solv-stoy-teknikk/optical-workbench/hardware/Optical Stage & Fittings/mini-optical-alignment-mechanism-workbench-model_files/1049401-mini-optical-alignment-mechanism-workbench-0076dabe-c984-4b47-a395-e0c5865c34db.pdf

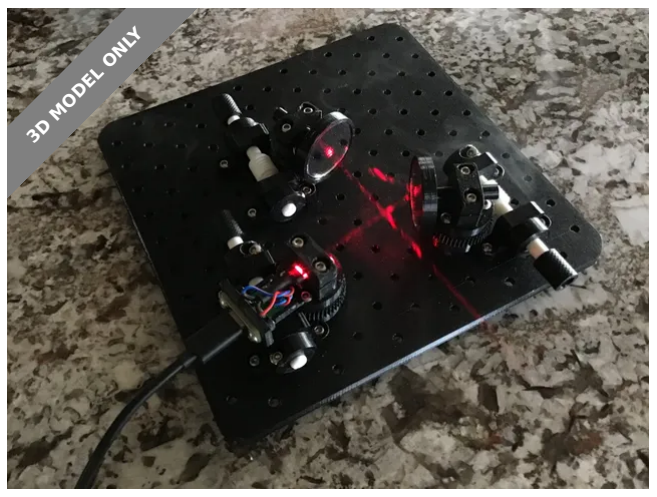
[picture p1: figure]
3D MODEL ONLY

## Summary

This is a handy Mini Optical Alignment Mechanism for 360° adjustments in the X-Y direction and a ± 10° tilt in the Z.

Learning (https://printables.com/model?categoryId=90) > Other 3D Objects for Learning (https://printables.com/model?categoryId=96)

Tags: | engineering | laser | classroom | scienceproject
scienceeducation | wormgear | teachingtool | optical
physicsproject | physicsexperiment | mathematicaldesgin
physicsdemonstration | educationalproject | positioner
educationaltools | lightshow | physicslab | classroomtools
physicsdemo | physicsclass | opticalworkbench | laserart

This MiniOptical Alignment Mechanism is a practical adjustment instrument designed to enable the precise positioning of lasers & optical components in all three dimensional spaces; i.e. X, Y, and Z. It includes a generic mounting platform for compatibility with a wide range of optical devices (with the use of an appropriate adapter); a dedicated mount for a 6mm dia. laser diode and a 25mm dia. mirror mount. The worm gear mechanism allows for smooth and accurate adjustments, ensuring optimal yba2cuo3 (https://printables.com/@yba2cuo3_12119)

## Mini Optical Alignment Mechanism & Workbench

VIEW IN BROWSER (https://printables.com/model/1049401-mini-optical-alignment-mechanism-workbench)

updated 2. 11. 2024 | published 2. 11. 2024

alignment in any test scenario. The design makes it an essential tool for any project requiring reliable positioning of optical components, from scientific or classroom experiments, to hobbyist projects, it delivers a cost-effective solution in a compact easy-to-use system.

STAY TUNED FOR UPCOMING PROJECTS INVOLVING THIS OPTICAL ALGINMENT MECHANISM!

Project Challenge #1: Lissajous Figure Laser Light-Show Pattern
Generator & Projector by yba2cuo3 | Download free STL model |
Printables.com (https://www.printables.com/model/1043751-lissajous-figure-laser-light-show-pattern-generato)

Features

Adaptable Mini-Optical Workbench for Demonstration & Experimentation;
360° Fine-Tunable Alignment Mechanism in the X-Y direction using Worm Gears;
± 10° Z-Tilt Adjustment using 3-sided pivot springs & screws; 6mm dia. Laser Diode Mount;
25mm dia. Mirror Mount;
Generic Component Mount to fit other optical components with custom adapters.
Dimensions: 165x165x40mm

It is designed to be used with this mini-optical workbench: Mini Optical
Workbench by yba2cuo3 | Download free STL model | Printables.com (https://www.printables.com/model/1049366-mini-optical-workbench)

Print Settings

Printer brand: Prusa
Model: i3 MK2S
Supports: Yes
Resolution: 0.15mm OPTIMAL Infill: 20%
Brim: Yes - 10 to 20mm
Filament brand: Doesn't matter Filament material: PLA
Filament color: Doesn't matter

Construction

The construction is relatively simple, making use of M3 hardware. A list of assembly material is provided below, along with where it's used. Also check the description associated with each file for more assembly details.

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
Assembly Tips:

Don't forget to insert the small printed sleeve inside the worm gear shaft hole to prevent wobbling;
There are 3 elongated mounting holes in the Mini Optical Workbench. This is where the worm gear screw/shaft goes. The slot allows for the adjustment of the worm gear distance to the worm with the ability to achieve a smooth & consistent rotation between both parts. When tightening the shaft nut, make sure that it is tight enough to prevent lateral or up & down movement of the gear, but not too tight which would prevent the free rotation of the gear;
The worm contact location on the worm gear can also be adjusted slightly; i.e. either ahead or behind the gear, by moving the position of the collars on the worm shaft;
Make sure that there is minimum play between the collars & pillow blocks but not too tight also to allow the free rotation of the worm. If everything is properly adjusted, the worm & gear should turn freely without any skipping of teeth or seizing.

List of Required Assembly Hardware

All HW is Stainless Steel Button Head Hex Socket Head Cap Screws and Nuts, unless specified otherwise.

•

•

•

•

•

Common (per Worm Gear Assembly)
Qty Description | Where Used
2 | M3 washer | Worm gear shaft washer - under screw head & nut
1 | M3 Nyloc nut | Worm gear shaft nut - install under workbench
4 | M3x8 screw | Pillow blocks
2 | M3x8 screw | Collars used on worm to restrict travel
1 | M3x8 screw | Knob at end of worm
1 | M3x16 screw | Worm gear shaft
3 | M3x16 screw | For Z-adjust. Secures worm gear to laser, mirror or generic mounts.
3 | 4mm Spring | Ball point pen Compression Spring for Z-adjust. Wire Diameter 0.4mm x Outer Diameter 4mm x Length 15mm. Note: You can cut your ball point spring to the appropriate length. Check: Amazon- spring (https://www.amazon.ca/gp/product/B08FMJN2P9/ref=ppx_yo_dt_b_search_asin_title?ie=UTF8&psc=1)

Laser Mount
Qty Description | Where Used
2 | M3x8 screw | For Laser mount (top)
1 | 6mm, 5mW Laser Diode | For Alignment of optical components. The wire leads will need to be soldered to the USB-c PCB; i.e. red wire to Vcc (or V marking on PCB) & blue (or black) to GND (or G). Check: Amazon-Laser (https://www.amazon.ca/gp/product/B07FM6FDFM/ref=ppx_yo_dt_b_search_asin_title?ie=UTF8&psc=1)
2 | M3x8 screw | For installing the USB-c PCB on the Laser Bottom Mount
1 | USB-c PCB | Female Socket for powering the +5VDC Laser. Use a standard +5VDC USB AC adapter. Check: Amazon-USBc (https://www.amazon.ca/gp/product/B0D5B96FBR/ref=ppx_yo_dt_b_search_asin_title?ie=UTF8&psc=1)

Mirror Mount (per)
Qty Description | Where Used
2 | M3x8 screw | For Mirror mount top
1 | 25mm Mirror | For Alignment. Check: Amazon-Mirror (https://www.amazon.ca/gp/product/B07T8YTBPJ/ref=ppx_yo_dt_b_search_asin_title?ie=UTF8&psc=1)
1 | Tape | Double sided tape for securing mirrors on mounts
Generic Component Mount (per)
Qty Description | Where Used
2 | M3x8 screw | For mounting generic components with custom adapter. You will need to design your own custom adapter to fit your special parts you want to test.

Post Processing Tools

Deburring tool for removing excess plastic from printed parts
Hand Drill or Drill Press (optional)
2.5mm or 7/64" drill bit for enlarging holes for M3 tap (optional)

DISCLAIMER:

This project incorporates a Class 3R (IIIa) laser with a power output of 5mW. This laser is designed for safe use under controlled conditions.

1.
2.
3.

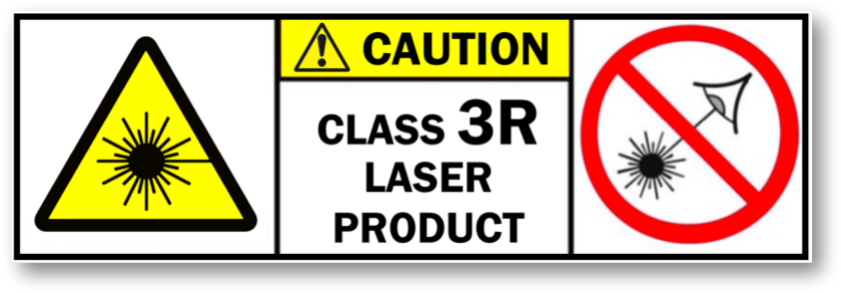
[picture p2: figure]

## Model files

Safety Precautions:

Do not stare into the laser beamdirectly.
Avoid pointing the laser at reflective surfacesor at eyes. Keep out of reach of children.
Use of protective eyewear is recommended for prolonged exposure.

By using this product, you acknowledge and accept all associated risks and responsibilities.

•
•
•
•

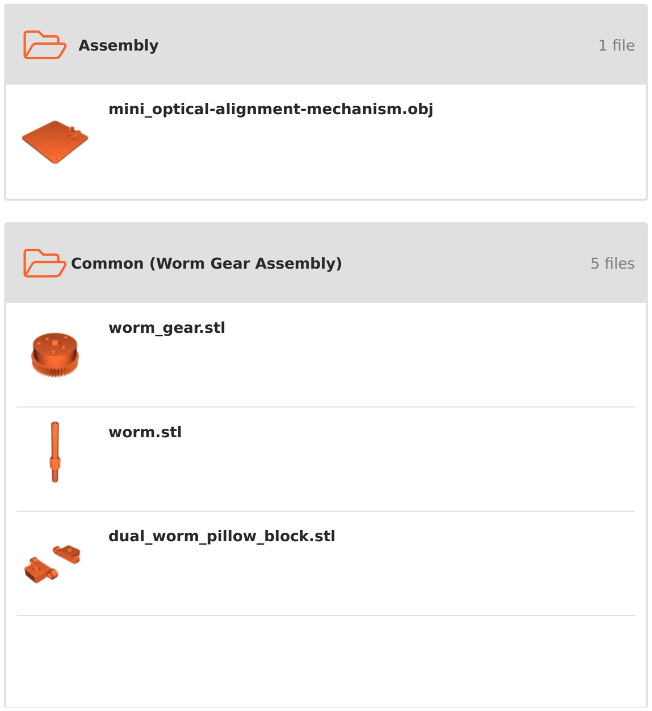
[picture p3: figure]
Assembly; 1 file; Common (Worm Gear Assembly); 5 files; mini_optical-alignment-mechanism.obj; worm_gear.stl; worm.stl; dual_worm_pillow_block.stl

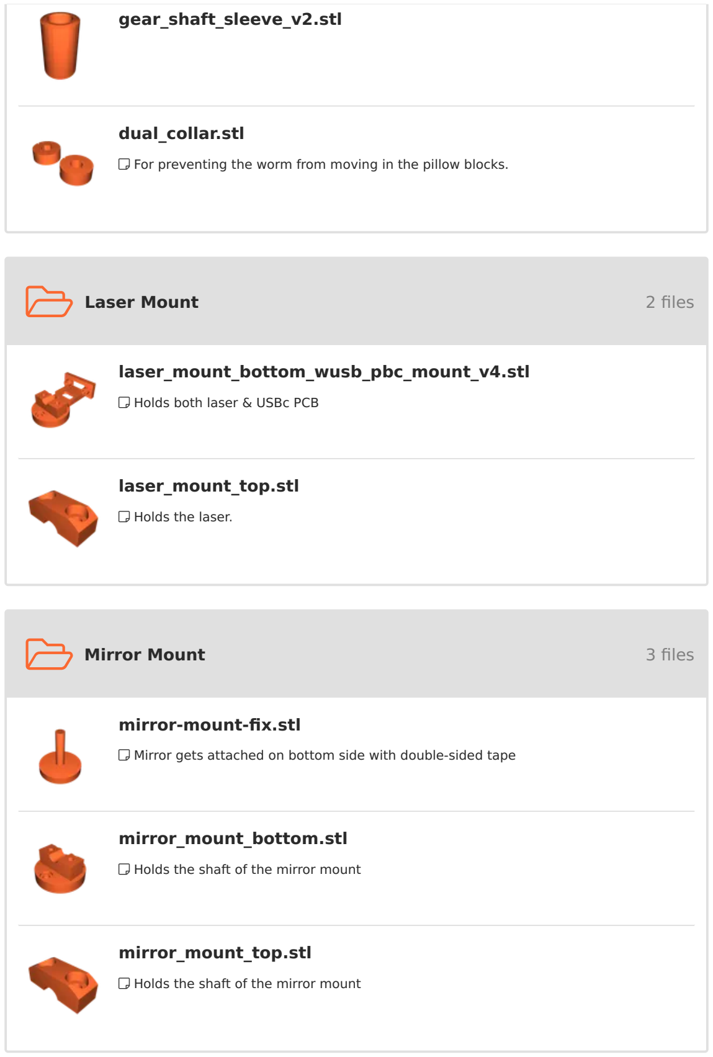
[picture p4: figure]
Laser Mount; 2 files; Holds both laser & USBc PCB; Holds the laser.; Mirror Mount; 3 files; Holds the shaft of the mirror mount; gear_shaft_sleeve_v2.stl; dual_collar.stl; laser_mount_bottom_wusb_pbc_mount_v4.stl; laser_mount_top.stl; mirror-mount-fix.stl; mirror_mount_bottom.stl; mirror_mount_top.stl

- For preventing the worm from moving in the pillow blocks.
- Mirror gets attached on bottom side with double-sided tape

- Generic Mount | 1 file
- Generic mount so you can add your own custom component adapter

## License

This work is licensed under a
Creative Commons (4.0 International License)

Attribution—Noncommercial—Share Alike (http://creativecommons.org/licenses/by-nc-sa/4.0/)

✖ | Sharing without ATTRIBUTION
✔ | Remix Culture allowed
✖ | Commercial Use
✖ | Free Cultural Works
✖ | Meets Open Definition

generic_alignment_mount.stl
