solv-stoy-teknikk/optical-workbench/hardware/Optical Stage & Fittings/mini-optical-workbench-model_files/1049366-mini-optical-workbench-0bf4b1d7-e2c4-493d-a009-b08b24fce8fa.pdf

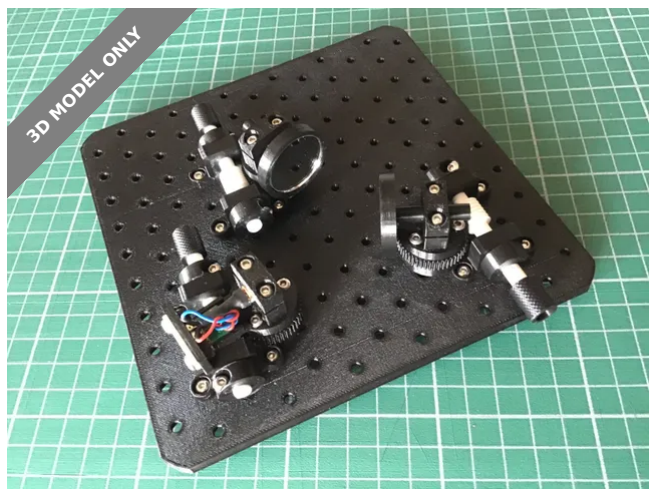
[picture p5: figure]
3D MODEL ONLY

## Summary

This is an adaptable mini-optical workbench for experimental & demonstration purposes built on M3 hardware.

Learning (https://printables.com/model?categoryId=90) > Other 3D Objects for Learning (https://printables.com/model?categoryId=96)

Tags: | laser | optical | opticalworkbench

This is an mini-optical workbench for experimental & demonstration purposes. Unlike the professional optical workbenches which use M6 threaded holes spaced 25mm apart for mounting larger components on a thick aluminum plate, this design uses M3 nuts which are secured on the underside of a printed PLA or ABS plate. Additionally, the mounting holes are spaced 25mm in the vertical direction and 15mm (staggered) in the vertical direction, which makes it ideal for mounting smaller optical components for testing. The plate measures 165x165mm and is 5mm thick with a total of 136 mounting holes.

UPDATE: You can use this optical workbench with this Printable design:
Mini Optical Alignment Mechanism & Workbench by yba2cuo3 | Download
free STL model | Printables.com (https://www.printables.com/model/1049401-mini-optical-alignment-mechanism-workbench)

yba2cuo3 (https://printables.com/@yba2cuo3_12119)

## Mini Optical Workbench

VIEW IN BROWSER (https://printables.com/model/1049366-mini-optical-workbench)

updated 28. 10. 2024 | published 28. 10. 2024

## Model files

- Upgraded version to accommodate for the Mini Optical Adjustment Assembly

## License

This work is licensed under a
Creative Commons (4.0 International License)

Attribution—Noncommercial—Share Alike (http://creativecommons.org/licenses/by-nc-sa/4.0/)

✖ | Sharing without ATTRIBUTION
✔ | Remix Culture allowed
✖ | Commercial Use
✖ | Free Cultural Works
✖ | Meets Open Definition

micro_optical_workbench_v2.stl
