solv-stoy-teknikk/optical-workbench/hardware/Optical Stage & Fittings/2-Axis Linear Stage/xy_translation_base.stl

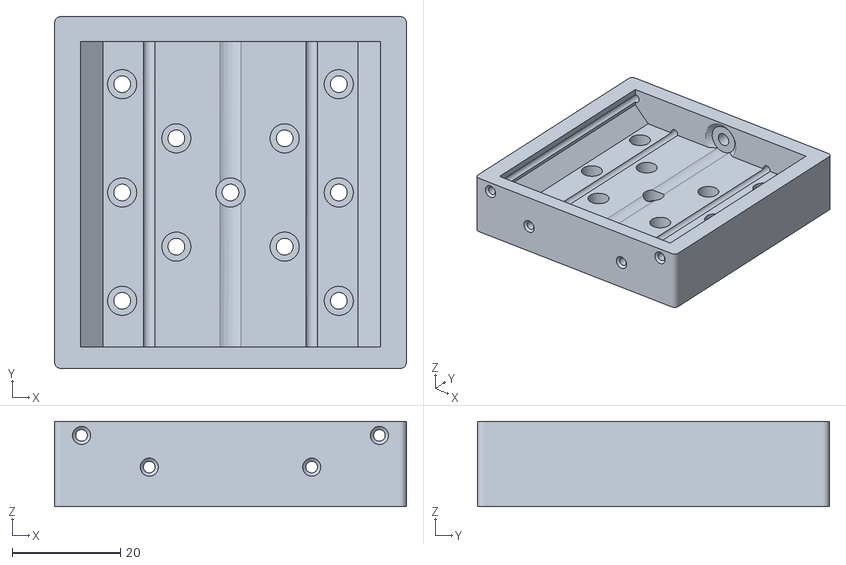
[picture p6: CAD file, 2024-11-29]
hardware/Optical Stage & Fittings/2-Axis Linear Stage/xy_translation_base.stl
65.0 x 65.0 x 15.8
