solv-stoy-teknikk/optical-workbench/hardware/Optical Stage & Fittings/Beam Splitter Stage/Beam Splitter Stage (10mm).3mf

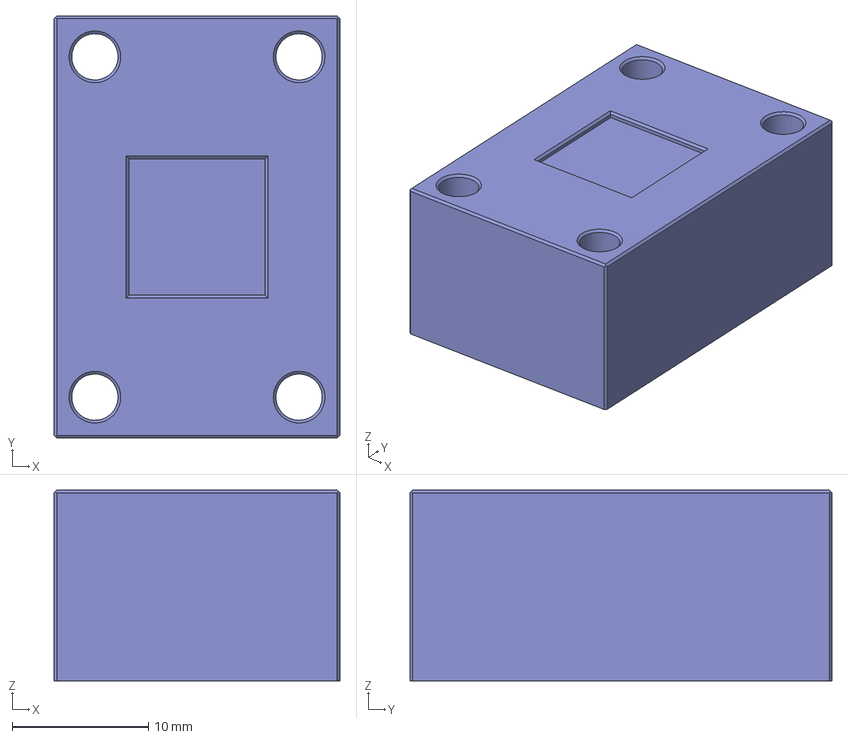
[picture p7: CAD file, 2024-11-29]
hardware/Optical Stage & Fittings/Beam Splitter Stage/Beam Splitter Stage (10mm).3mf
21.0 x 31.0 x 14.0 mm
