solv-stoy-teknikk/optical-workbench/hardware/Optical Stage & Fittings/Diode Laser Cage/Diode Laser Cage v1.3mf

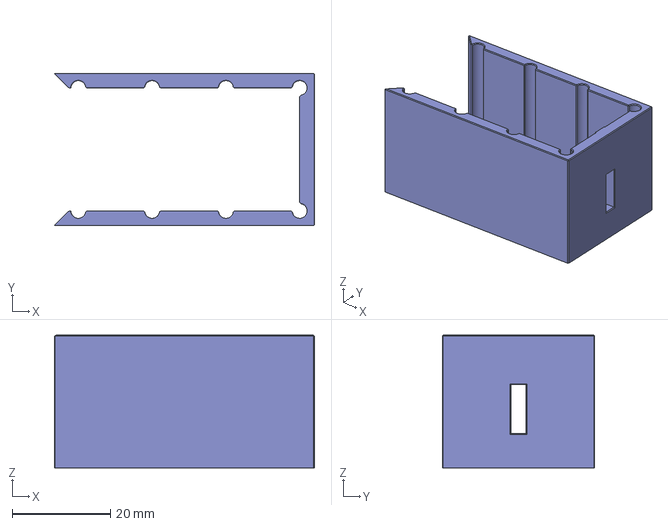
[picture p8: CAD file, 2024-11-29]
hardware/Optical Stage & Fittings/Diode Laser Cage/Diode Laser Cage v1.3mf
52.9 x 31.0 x 27.0 mm
