solv-stoy-teknikk/optical-workbench/hardware/Optical Stage & Fittings/mini-optical-alignment-mechanism-workbench-model_files/Assembly/mini_optical-alignment-mechanism.3mf

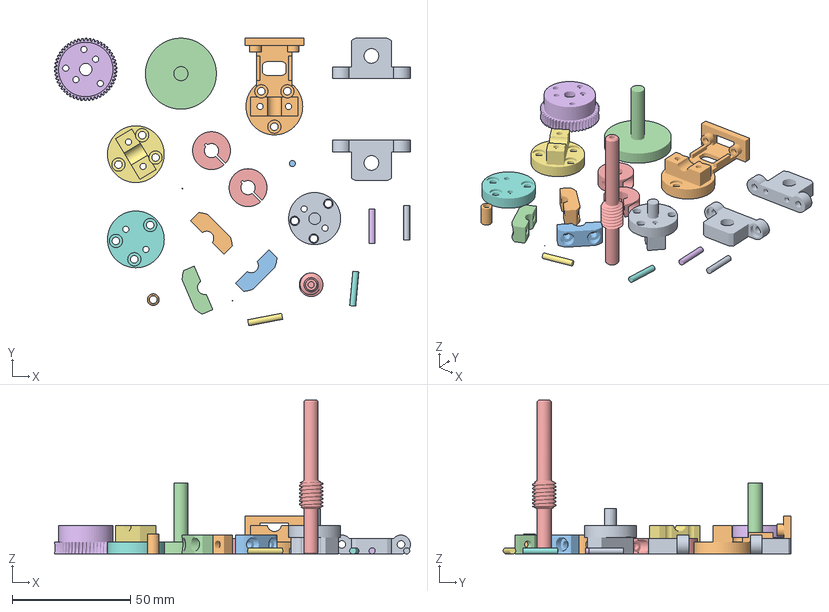
[picture p9: CAD file, 2024-11-29]
hardware/Optical Stage & Fittings/mini-optical-alignment-mechanism-workbench-model_files/Assembly/mini_optical-alignment-mechanism.3mf
150.4 x 121.5 x 65.0 mm
dual_worm_pillow_block.stl
Laser_Mount_Bottom_wUSB_PBC_Mount_v4.stl
mini_optical-alignment-mechanism.obj_4
mirror-mount-fix.stl
dual_collar.stl
Worm_Gear.stl
Mirror_Mount_Bottom.stl
generic_alignment_mount.stl
mini_optical-alignment-mechanism.obj_3
mini_optical-alignment-mechanism.obj_10
Mirror_Mount_Top.stl
laser_mount_top.stl
worm.stl
mini_optical-alignment-mechanism.obj_6
mini_optical-alignment-mechanism.obj_8
mini_optical-alignment-mechanism.obj_5
mini_optical-alignment-mechanism.obj_7
Gear_Shaft_Sleeve_v2.stl
mini_optical-alignment-mechanism.obj_2
mini_optical-alignment-mechanism.obj_9
