solv-stoy-teknikk/optical-workbench/hardware/Optical Stage & Fittings/mini-optical-alignment-mechanism-workbench-model_files/Common (Worm Gear Assembly)/worm.stl

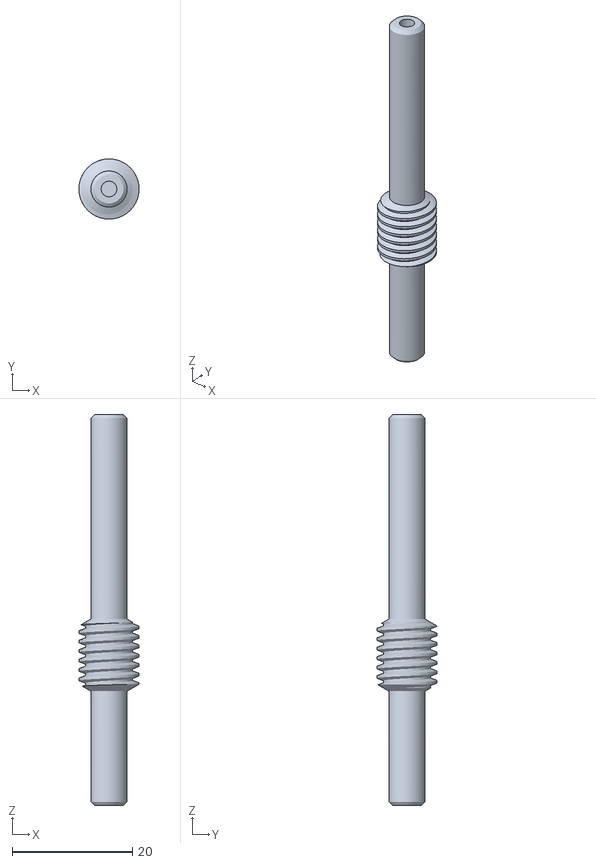
[picture p10: CAD file, 2024-11-29]
hardware/Optical Stage & Fittings/mini-optical-alignment-mechanism-workbench-model_files/Common (Worm Gear Assembly)/worm.stl
10.0 x 10.0 x 65.0
