solv-stoy-teknikk/optical-workbench/hardware/Optical Stage & Fittings/mini-optical-alignment-mechanism-workbench-model_files/Generic Mount/generic_alignment_mount.stl

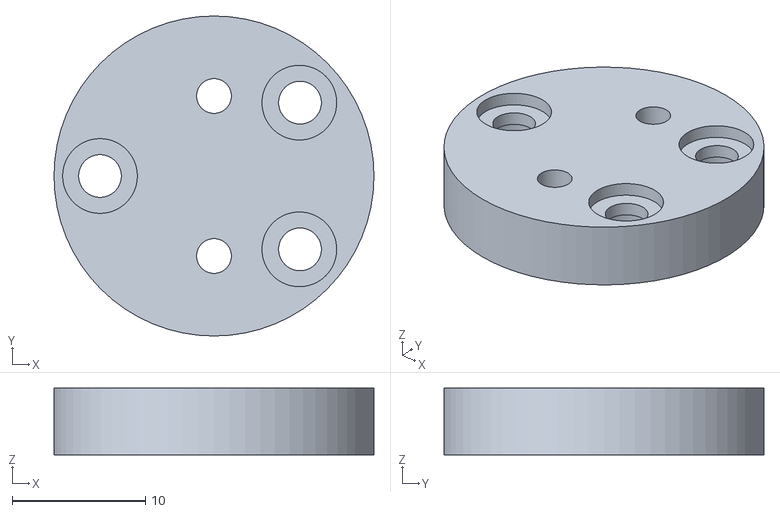
[picture p11: CAD file, 2024-11-29]
hardware/Optical Stage & Fittings/mini-optical-alignment-mechanism-workbench-model_files/Generic Mount/generic_alignment_mount.stl
24.0 x 24.0 x 5.00
