solv-stoy-teknikk/optical-workbench/hardware/Optical Stage & Fittings/mini-optical-alignment-mechanism-workbench-model_files/Laser Mount/laser_mount_top.stl

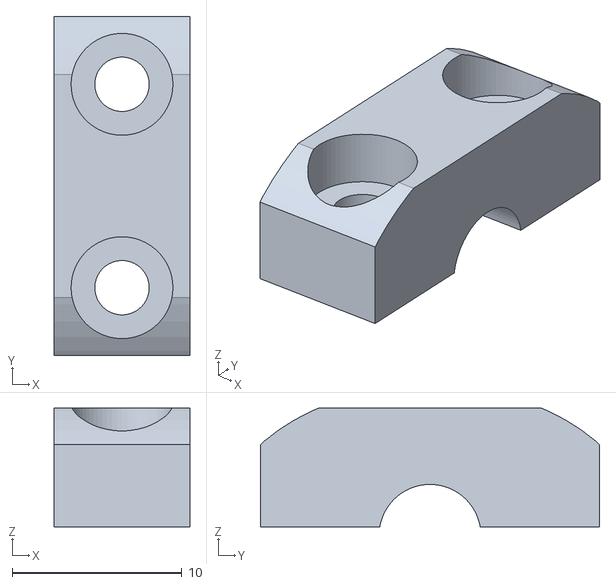
[picture p12: CAD file, 2024-11-29]
hardware/Optical Stage & Fittings/mini-optical-alignment-mechanism-workbench-model_files/Laser Mount/laser_mount_top.stl
8.00 x 20.0 x 7.00
