solv-stoy-teknikk/optical-workbench/hardware/Optical Stage & Fittings/mini-optical-alignment-mechanism-workbench-model_files/mini_optical-alignment-mechanism.3mf

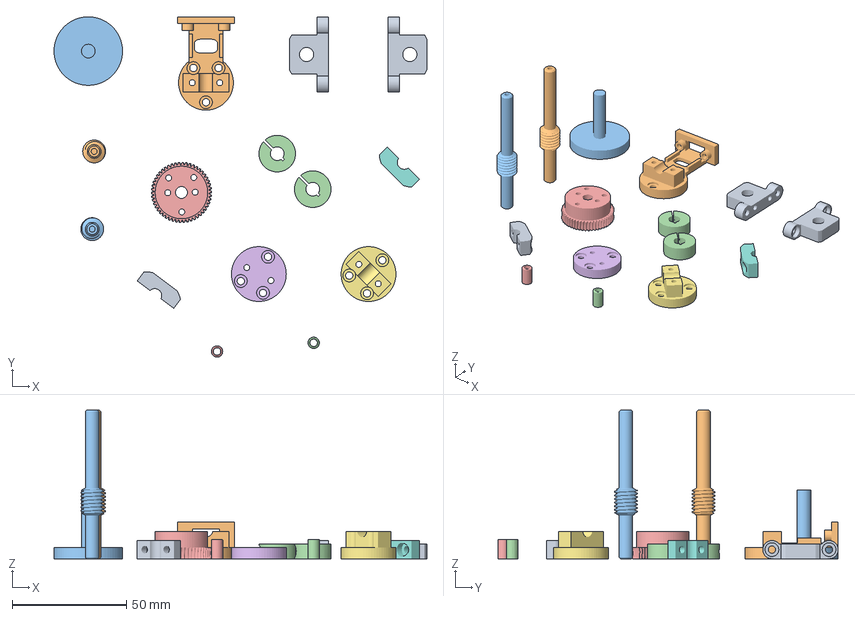
[picture p13: CAD file, 2024-11-29]
hardware/Optical Stage & Fittings/mini-optical-alignment-mechanism-workbench-model_files/mini_optical-alignment-mechanism.3mf
163.2 x 148.9 x 65.0 mm
dual_worm_pillow_block.stl
Laser_Mount_Bottom_wUSB_PBC_Mount_v4.stl
mirror-mount-fix.stl
dual_collar.stl
Worm_Gear.stl
generic_alignment_mount.stl
Mirror_Mount_Bottom.stl
Mirror_Mount_Top.stl
laser_mount_top.stl
worm.stl x 2
Gear_Shaft_Sleeve_v2.stl x 2
