solv-stoy-teknikk/optical-workbench/hardware/Optical Stage & Fittings/mini-optical-workbench-model_files/Micro_Optical_Workbench_v2.3mf

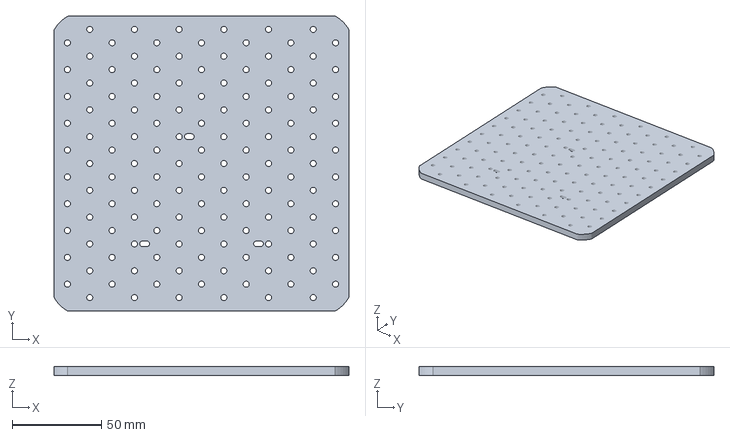
[picture p14: CAD file, 2024-11-29]
hardware/Optical Stage & Fittings/mini-optical-workbench-model_files/Micro_Optical_Workbench_v2.3mf
165.0 x 165.0 x 5.00 mm
