solv-stoy-teknikk/optical-workbench/hardware/Optical Stage & Fittings/2-Axis Linear Stage/xyz-cutting-guide.stl

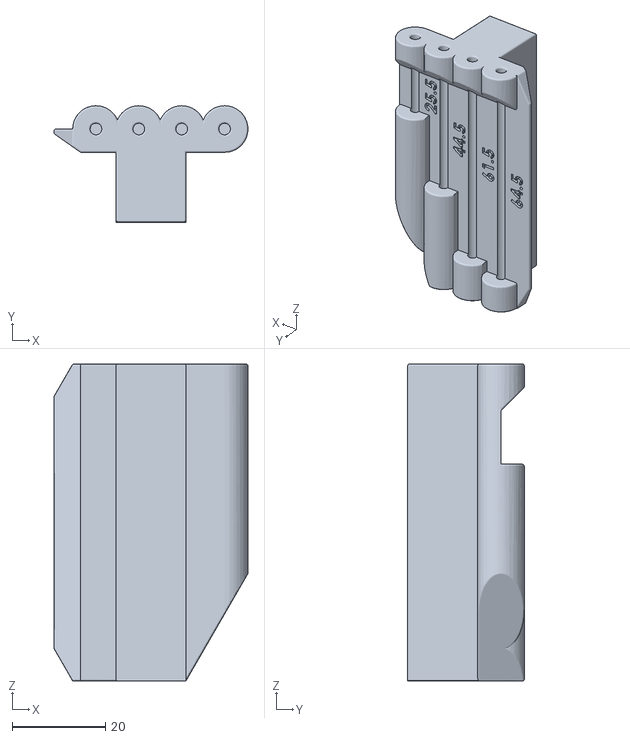
[picture p15: CAD file, 2024-11-29]
hardware/Optical Stage & Fittings/2-Axis Linear Stage/xyz-cutting-guide.stl
41.6 x 25.0 x 68.0
