solv-stoy-teknikk/optical-workbench/hardware/Optical Stage & Fittings/mini-optical-alignment-mechanism-workbench-model_files/Common (Worm Gear Assembly)/dual_worm_pillow_block.stl

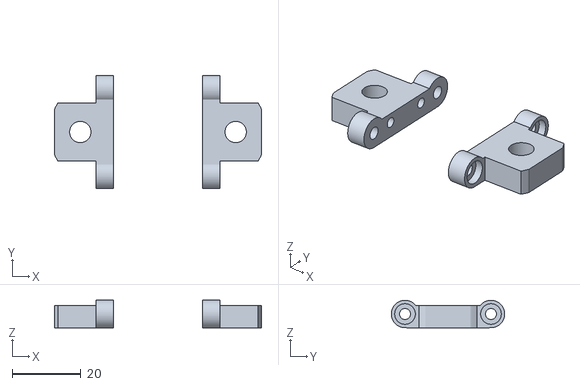
[picture p16: CAD file, 2024-11-29]
hardware/Optical Stage & Fittings/mini-optical-alignment-mechanism-workbench-model_files/Common (Worm Gear Assembly)/dual_worm_pillow_block.stl
60.2 x 33.0 x 8.00
