solv-stoy-teknikk/optical-workbench/hardware/Optical Stage & Fittings/mini-optical-alignment-mechanism-workbench-model_files/Laser Mount/Laser_Mount_Bottom_wUSB_PBC_Mount_v4.stl

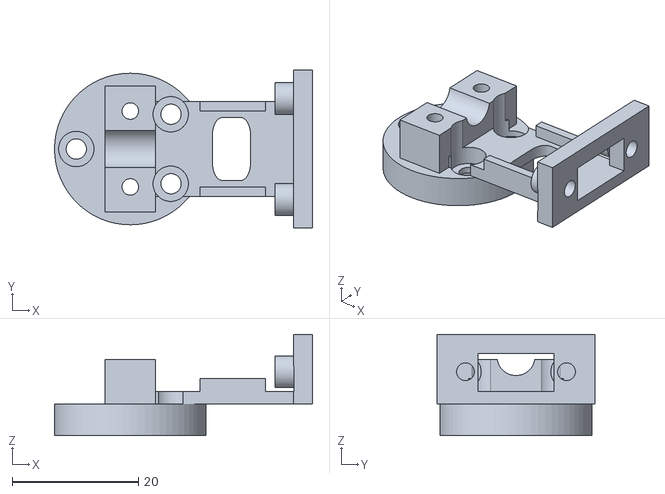
[picture p17: CAD file, 2024-11-29]
hardware/Optical Stage & Fittings/mini-optical-alignment-mechanism-workbench-model_files/Laser Mount/Laser_Mount_Bottom_wUSB_PBC_Mount_v4.stl
40.8 x 25.0 x 16.0
