solv-stoy-teknikk/optical-workbench/hardware/Optical Stage & Fittings/mini-optical-alignment-mechanism-workbench-model_files/Mirror Mount/Mirror_Mount_Bottom.stl

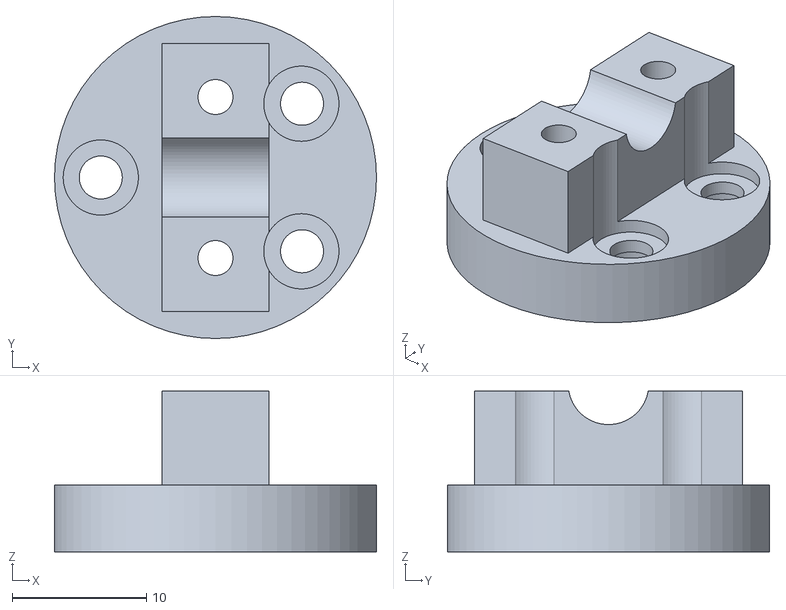
[picture p18: CAD file, 2024-11-29]
hardware/Optical Stage & Fittings/mini-optical-alignment-mechanism-workbench-model_files/Mirror Mount/Mirror_Mount_Bottom.stl
24.0 x 24.0 x 12.0
