solv-stoy-teknikk/optical-workbench/hardware/Optical Stage & Fittings/2-Axis Linear Stage/knob.3mf

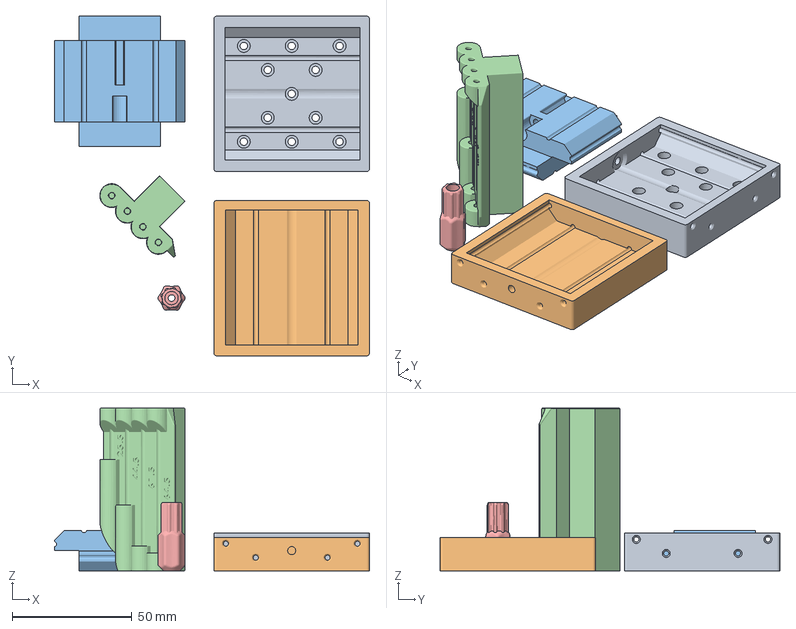
[picture p19: CAD file, 2024-11-29]
hardware/Optical Stage & Fittings/2-Axis Linear Stage/knob.3mf
131.6 x 142.0 x 68.0 mm
xy_translation_base.stl
xy_translation_top.stl
xy_translation_center.stl
xyz-cutting-guide.stl
knob.stl
