solv-stoy-teknikk/optical-workbench/hardware/Optical Stage & Fittings/mini-optical-alignment-mechanism-workbench-model_files/Common (Worm Gear Assembly)/Gear_Shaft_Sleeve_v2.stl

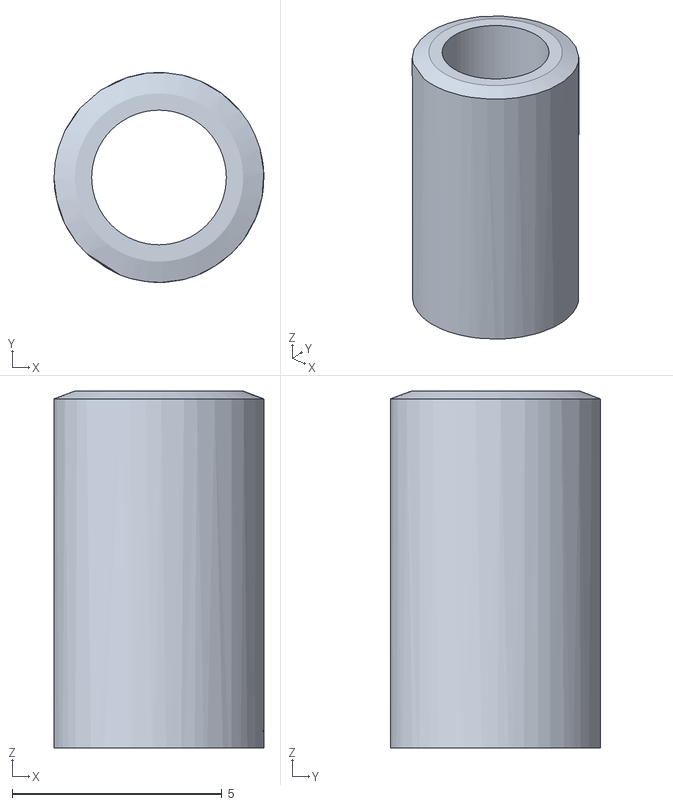
[picture p20: CAD file, 2024-11-29]
hardware/Optical Stage & Fittings/mini-optical-alignment-mechanism-workbench-model_files/Common (Worm Gear Assembly)/Gear_Shaft_Sleeve_v2.stl
5.00 x 5.00 x 8.50
