solv-stoy-teknikk/optical-workbench/hardware/Optical Stage & Fittings/mini-optical-alignment-mechanism-workbench-model_files/Mirror Mount/mirror-mount-fix.stl

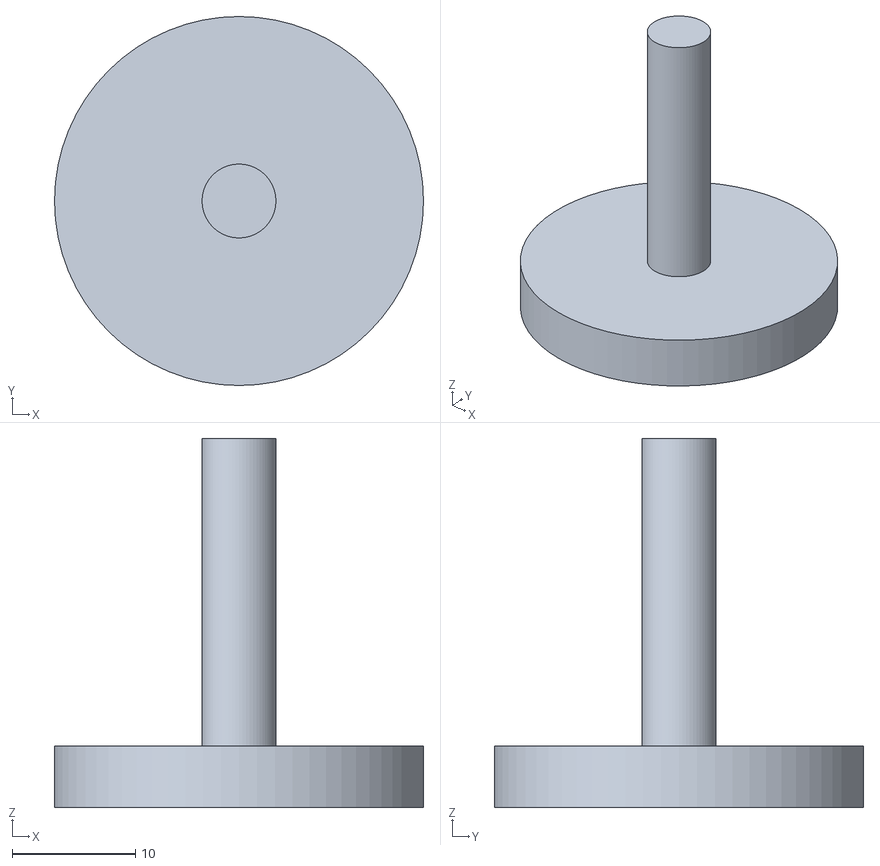
[picture p21: CAD file, 2024-11-29]
hardware/Optical Stage & Fittings/mini-optical-alignment-mechanism-workbench-model_files/Mirror Mount/mirror-mount-fix.stl
30.0 x 30.0 x 30.0
