solv-stoy-teknikk/optical-workbench/hardware/Optical Stage & Fittings/2-Axis Linear Stage/xy_translation_center.stl

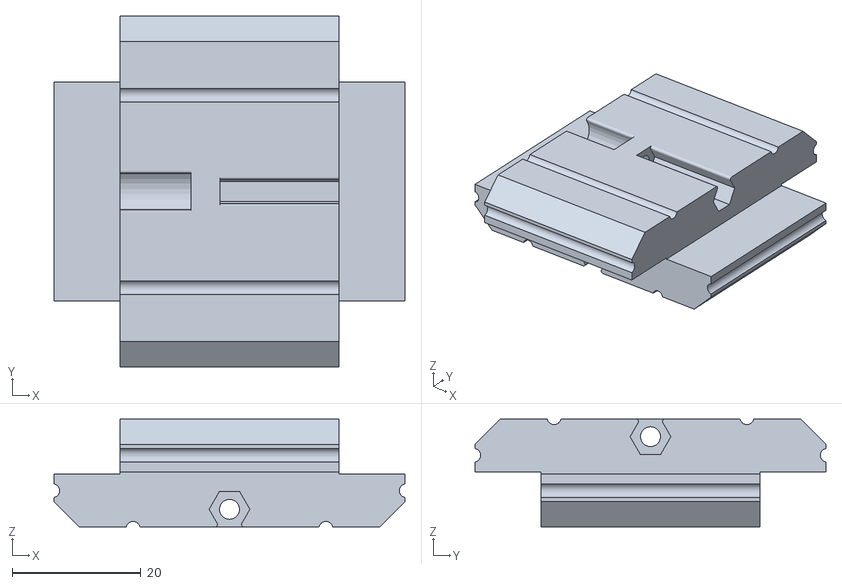
[picture p22: CAD file, 2024-11-29]
hardware/Optical Stage & Fittings/2-Axis Linear Stage/xy_translation_center.stl
54.6 x 54.6 x 16.8
