solv-stoy-teknikk/optical-workbench/hardware/Optical Stage & Fittings/mini-optical-alignment-mechanism-workbench-model_files/Common (Worm Gear Assembly)/dual_collar.stl

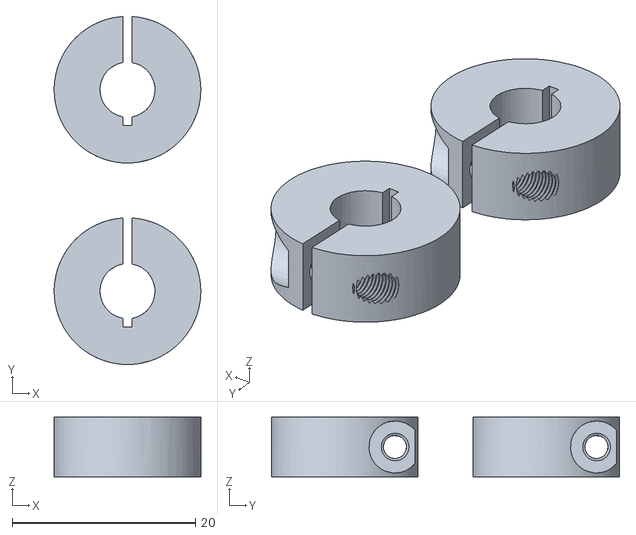
[picture p23: CAD file, 2024-11-29]
hardware/Optical Stage & Fittings/mini-optical-alignment-mechanism-workbench-model_files/Common (Worm Gear Assembly)/dual_collar.stl
16.0 x 38.0 x 6.50
