solv-stoy-teknikk/optical-workbench/hardware/Optical Stage & Fittings/2-Axis Linear Stage/xy_translation_top.stl

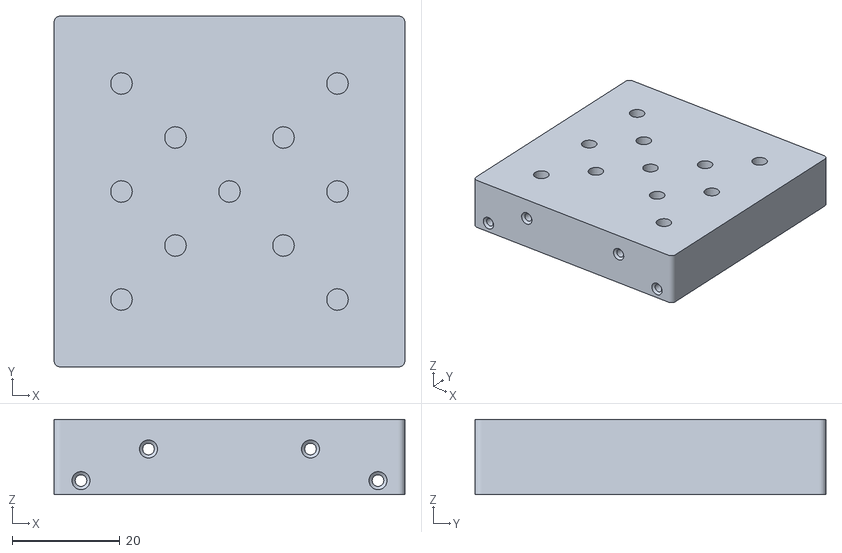
[picture p24: CAD file, 2024-11-29]
hardware/Optical Stage & Fittings/2-Axis Linear Stage/xy_translation_top.stl
65.0 x 65.0 x 13.9
