solv-stoy-teknikk/optical-workbench/(list of files, cad)

Other CAD files:
hardware/Optical Stage & Fittings/2-Axis Linear Stage/knob.stl
