solv-stoy-teknikk/optical-workbench/hardware/Optical Stage & Fittings/2-Axis Linear Stage/903033-two-axis-printed-linear-stage-2fd26770-67e8-4b62-a9f2-98f47c20600e.pdf

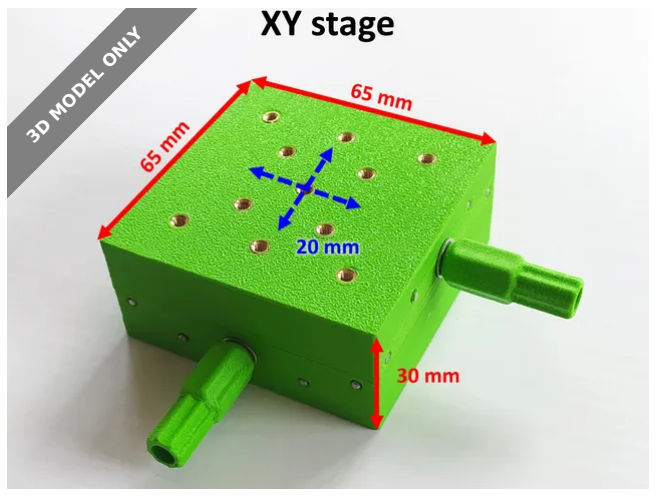
[picture p25: figure]
3D MODEL ONLY

## Summary

This design is a two axis printed linear stage capable of a positioning accuracy in the order of 10 micron. Besides 3D...

Hobby & Makers (https://printables.com/model?categoryId=48) > Tools (https://printables.com/model?categoryId=49)

Tags: | stage | platform | thingiverse | translation

This design is a two axis printed linear stage capable of a positioning accuracy in the order of 10 micron. Besides 3D printed parts it only uses 2mm metallic rods, two 40mm spring and two 55mm M3 bolt with nut and washer. The complete fabrication process is described in an instructable: https://www.instructables.com/Build-a-3D-Printed-Linear-Stage/

I also designed a 2 axis translation stage, a transversal translation stage and two rotation stages. All 3D files will be available shortly:

https://www.printables.com/model/903034-printed-linear-stage

https://www.printables.com/model/903032-orthogonal-printed-linear-stage

Category: Tools

RemiRafael (https://printables.com/@RemiRafael)

## Two axis printed linear stage

VIEW IN BROWSER (https://printables.com/model/903033-two-axis-printed-linear-stage)

updated 27. 10. 2024 | published 27. 10. 2024

## Model files

Find source .stl files on Thingiverse.com (https://www.thingiverse.com/thing:6650153)

## License

This work is licensed under a
Creative Commons (4.0 International License)

Attribution-NonCommercial (http://creativecommons.org/licenses/by-nc/4.0/)

✖ | Sharing without ATTRIBUTION
✔ | Remix Culture allowed
✖ | Commercial Use
✖ | Free Cultural Works
✖ | Meets Open Definition

xy_translation_base.stl

xy_translation_center.stl

xy_translation_top.stl

knob.stl

xyz-cutting-guide.stl
