solv-stoy-teknikk/optical-workbench/(commit log)

2024-11-29 Added Optical Stage & Fittings
    [Beam Splitter Stage (10mm).3mf, Diode Laser Cage v1.3mf, Gear_Shaft_Sleeve_v2.stl, Laser_Mount_Bottom_wUSB_PBC_Mount_v4.stl, Micro_Optical_Workbench_v2.3mf, Mirror_Mount_Bottom.stl, Mirror_Mount_Top.stl, dual_collar.stl]
2024-11-29 Update .DS_Store, .DS_Store, 903033-two-axis-printed-linear-stage-2fd26770-67e8-4b62-a9f2-98f47c20600e.pdf, and 63 more files
    [Beam Splitter Stage (10mm).3mf, Diode Laser Cage v1.3mf, Gear_Shaft_Sleeve_v2.stl, Laser_Mount_Bottom_wUSB_PBC_Mount_v4.stl, Micro_Optical_Workbench_v2.3mf, Mirror_Mount_Bottom.stl, Mirror_Mount_Top.stl, dual_collar.stl]
